sensai7/Card-Sized-Midi-Controller/(list of files, drawings)

Other design files:
Kicad/CardSizeMidiController/CardSizeMidiController.dsn
