sensai7/Card-Sized-Midi-Controller/Kicad/CardSizeMidiController/CardSizeMidiController.kicad_sch

## KiCad design Kicad/CardSizeMidiController/CardSizeMidiController.kicad_sch (2024-09-10)

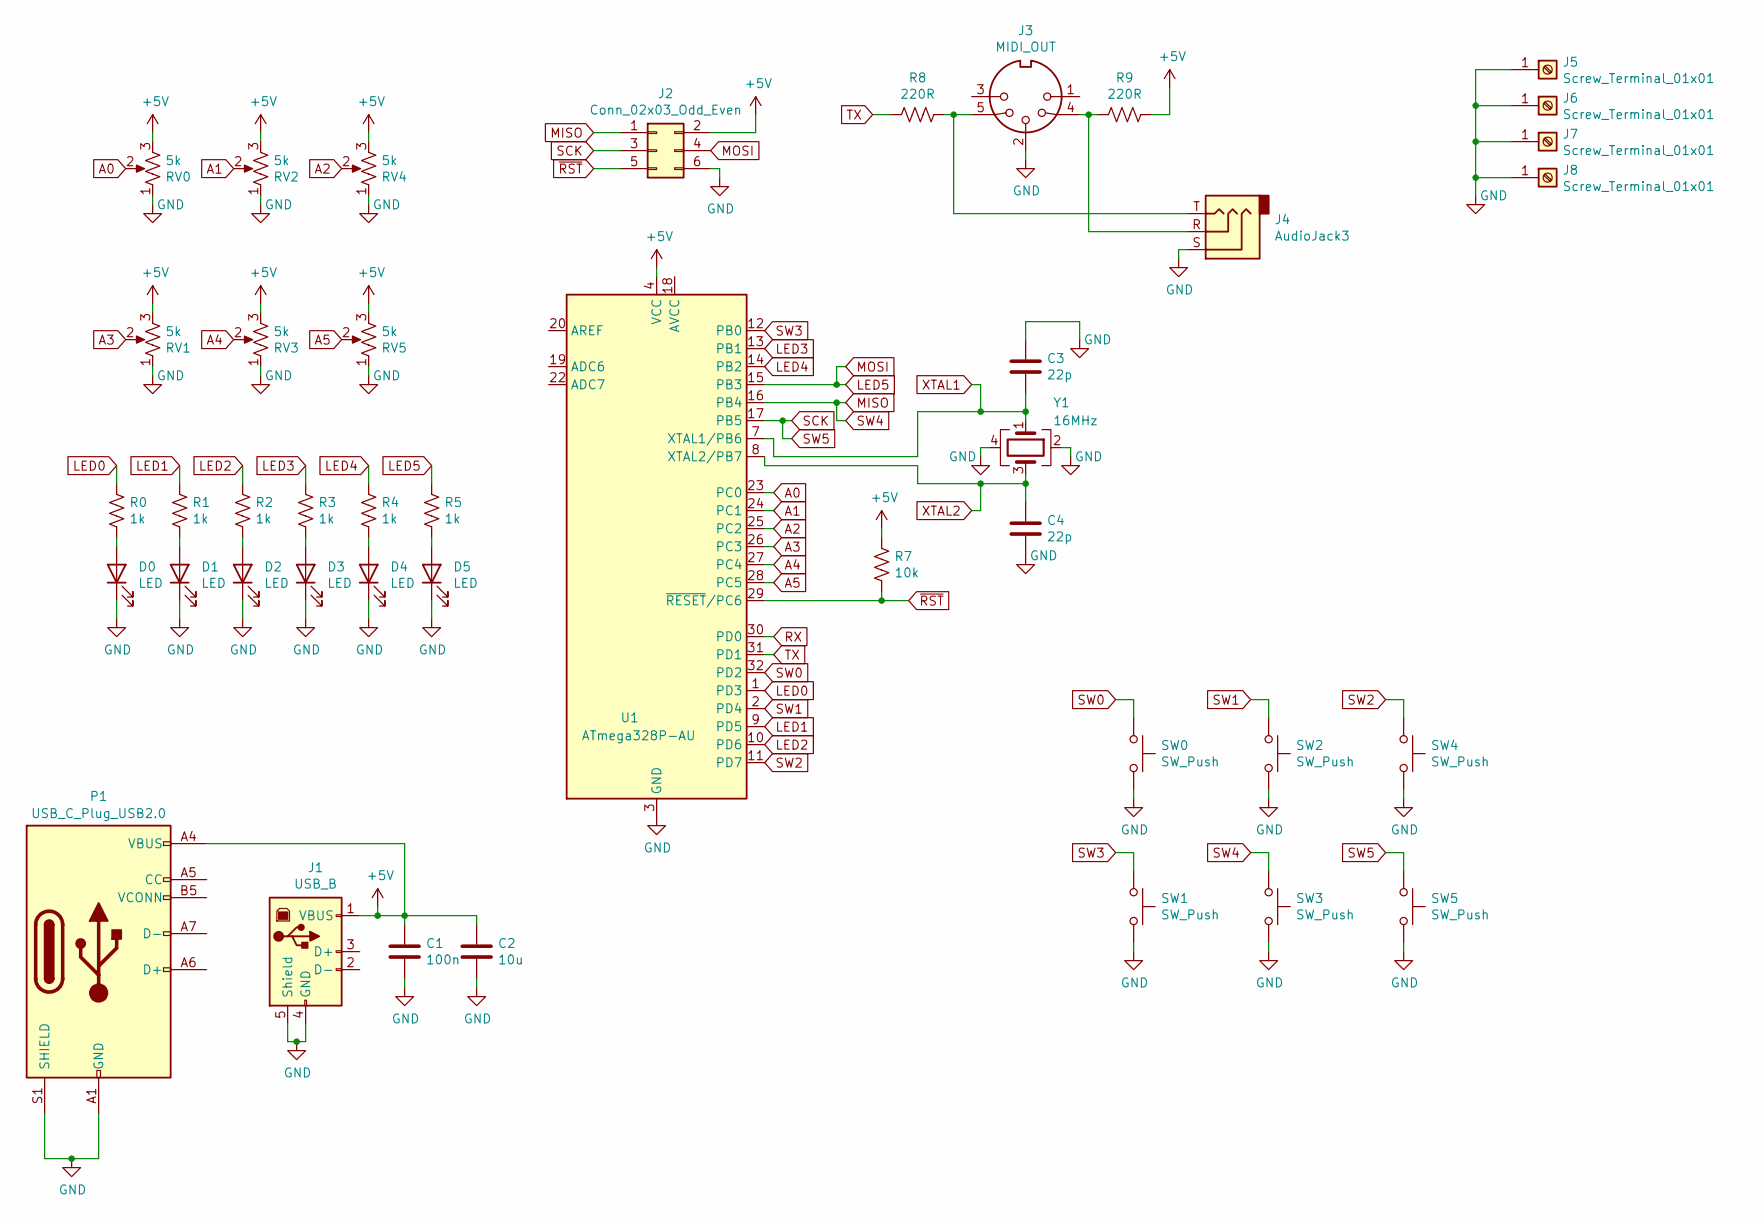
[picture p1: schematic CardSizeMidiController.kicad_sch]

Parts:
C1: 100n; C_0805_2012Metric_Pad1.18x1.45mm_HandSolder; LCSC C49678
C2: 10u; C_0805_2012Metric_Pad1.18x1.45mm_HandSolder; LCSC C15850
C3, C4: 22p; C_0603_1608Metric_Pad1.08x0.95mm_HandSolder; LCSC C1653
D0, D1, D2, D3, D4, D5: LED; LED_0805_2012Metric; LCSC C34499
J1: USB_B; USB_B_OST_USB-B1HSxx_Horizontal
J2: Conn_02x03_Odd_Even; PinHeader_2x03_P2.54mm_Vertical
J3: MIDI_OUT; din-5; LCSC C2939346
J4: AudioJack3; Jack stereo tayda
J5, J6, J7, J8: Screw_Terminal_01x01; MountingHole_4.3mm_M4_Pad_Via
P1: USB_C_Plug_USB2.0; USB_C_Receptacle_GCT_USB4105-xx-A_16P_TopMnt_Horizontal; LCSC C2765186
R0, R1, R2, R3, R4, R5: 1k; R_0805_2012Metric_Pad1.20x1.40mm_HandSolder; LCSC C17513
R7: 10k; R_0805_2012Metric_Pad1.20x1.40mm_HandSolder; LCSC C17414
R8, R9: 220R; R_0805_2012Metric_Pad1.20x1.40mm_HandSolder; LCSC C17557
RV0, RV1, RV2, RV3, RV4, RV5: 5k; trimmer_alps-rk09k1130ah1; LCSC C470296
SW0, SW1, SW2, SW3, SW4, SW5: SW_Push; SW_Push_1P1T_NO_6x6mm_H9.5mm; LCSC C127509
U1: ATmega328P-AU; TQFP-32_7x7mm_P0.8mm; LCSC C132230
Y1: 16MHz; Crystal_SMD_3225-4Pin_3.2x2.5mm; LCSC C13738

Connections:
+5V: C1.1, C2.1, J1.1 (VBUS), J2.2, P1.A4 (VBUS), P1.A9 (VBUS), P1.B4 (VBUS), P1.B9 (VBUS), R7.1, R9.1, RV0.3, RV1.3, RV2.3, RV3.3, RV4.3, RV5.3, U1.4 (VCC), U1.6 (VCC)
A0: RV0.2, U1.23 (PC0)
A1: RV2.2, U1.24 (PC1)
A2: RV4.2, U1.25 (PC2)
A3: RV1.2, U1.26 (PC3)
A4: RV3.2, U1.27 (PC4)
A5: RV5.2, U1.28 (PC5)
GND: C1.2, C2.2, C3.1, C4.2, D0.1 (K), D1.1 (K), D2.1 (K), D3.1 (K), D4.1 (K), D5.1 (K), J1.4 (GND), J1.5 (Shield), J2.6, J3.2, J4.S, J5.1, J6.1, J7.1, J8.1, P1.A1 (GND), P1.A12 (GND), P1.B1 (GND), P1.B12 (GND), P1.S1 (SHIELD), RV0.1, RV1.1, RV2.1, RV3.1, RV4.1, RV5.1, SW0.2, SW1.2, SW2.2, SW3.2, SW4.2, SW5.2, U1.3 (GND), U1.5 (GND), U1.21 (GND), Y1.2, Y1.4
LED0: R0.1, U1.1 (PD3)
LED1: R1.1, U1.9 (PD5)
LED2: R2.1, U1.10 (PD6)
LED3: R3.1, U1.13 (PB1)
LED4: R4.1, U1.14 (PB2)
LED5: J2.4, R5.1, U1.15 (PB3)
MISO: J2.1, SW3.1, U1.16 (PB4)
unnamed: D0.2 (A), R0.2
unnamed: D1.2 (A), R1.2
unnamed: D2.2 (A), R2.2
unnamed: D3.2 (A), R3.2
unnamed: D4.2 (A), R4.2
unnamed: D5.2 (A), R5.2
unnamed: J3.4, J4.R, R9.2
unnamed: J3.5, J4.T, R8.1
RX: U1.30 (PD0)
SCK: J2.3, SW5.1, U1.17 (PB5)
SW0: SW0.1, U1.32 (PD2)
SW1: SW2.1, U1.2 (PD4)
SW2: SW4.1, U1.11 (PD7)
SW3: SW1.1, U1.12 (PB0)
TX: R8.2, U1.31 (PD1)
XTAL1: C3.2, U1.7 (XTAL1/PB6), Y1.1
XTAL2: C4.1, U1.8 (XTAL2/PB7), Y1.3
~RST: J2.5, R7.2, U1.29 (~RESET/PC6)
