sensai7/Card-Sized-Midi-Controller/Code/CardSizeMidiController-NTS-3/PushButton.cpp

#include "PushButton.h"

// Constructor
PushButton::PushButton(uint8_t pin) {
  this->pin = pin;
  this->buttonState = HIGH;
  this->lastButtonState = HIGH;
  pinMode(pin, INPUT_PULLUP);
}

bool PushButton::instantRead(){
  lastButtonState = buttonState;
  buttonState = digitalRead(pin);
  return buttonState;
}

bool PushButton::isPressed() {
  return (digitalRead(pin) == LOW);
}

bool PushButton::isReleased() {
  return (digitalRead(pin) == HIGH);
}

bool PushButton::wasJustPressed() {
  return (instantRead() == LOW && lastButtonState == HIGH);
}

bool PushButton::wasJustReleased() {
  return (instantRead() == HIGH && lastButtonState == LOW);
}
