sensai7/Card-Sized-Midi-Controller/(commit log)

2024-09-10 0.5 hardware and new code wip
    [CardSizeMidiController.csv, CardSizeMidiController.dsn, CardSizeMidiController.kicad_pcb, CardSizeMidiController.kicad_sch]
2024-09-12 fixed led bug, changed map with shift
    [Potentiometer.cpp, extra.cpp]
2024-09-14 newest fabrication 0.5
    [CardSizeMidiController.kicad_pcb, bom.csv, designators.csv, positions.csv]
2024-09-16 Changed midi connector for size restrictions
    [bom.csv]
2024-09-16 Fixed switch rotation
    [positions.csv]
2024-09-16 Update pot positions
    [positions.csv]
